shawnnjupt/MIC-Xcorr/README.md

# mic_xcorr

#### 介绍
使用gw2a(tang 20k)进行声源定位的工程，配合sipeed的6+1麦克风

演示视频在这里
https://www.bilibili.com/video/BV1pd4y147E5/?vd_source=da71ba5d951341a80076c3fa4981655b
屏幕截图
