shawnnjupt/MIC-Xcorr/impl/gwsynthesis/top_syn_resource.html

# Hierarchy Module Resource

MODULE NAME | REG NUMBER | ALU NUMBER | LUT NUMBER | DSP NUMBER | BSRAM NUMBER | SSRAM NUMBER
top (F:/code/fpga/MIC_HDMI_FINISHED/src/top.v) | 1818 | 208 | 2395 | - | 16 | 117
|--cmos_pll_m0 (F:/code/fpga/MIC_HDMI_FINISHED/src/top.v) | - | - | - | - | - | -
|--mem_pll_m0 (F:/code/fpga/MIC_HDMI_FINISHED/src/top.v) | - | - | - | - | - | -
|--i2c_config_m0 (F:/code/fpga/MIC_HDMI_FINISHED/src/top.v) | 13 | - | 38 | - | - | -
|--i2c_master_top_m0 (F:/code/fpga/MIC_HDMI_FINISHED/src/i2c_master/i2c_config.v) | 17 | - | 690 | - | - | -
|--byte_controller (F:/code/fpga/MIC_HDMI_FINISHED/src/i2c_master/i2c_master_top.v) | 23 | - | 50 | - | - | -
|--bit_controller (F:/code/fpga/MIC_HDMI_FINISHED/src/i2c_master/i2c_master_byte_ctrl.v) | 71 | 15 | 90 | - | - | -
|--cmos_8_16bit_m0 (F:/code/fpga/MIC_HDMI_FINISHED/src/top.v) | 29 | - | 3 | - | - | -
|--syn_gen_inst (F:/code/fpga/MIC_HDMI_FINISHED/src/top.v) | 48 | 8 | 60 | - | - | -
|--u_tmds_rpll (F:/code/fpga/MIC_HDMI_FINISHED/src/top.v) | - | - | - | - | - | -
|--vitual_image_inst (F:/code/fpga/MIC_HDMI_FINISHED/src/top.v) | 56 | 196 | 1224 | 21 | - | -
|--mic_serial_inst (F:/code/fpga/MIC_HDMI_FINISHED/src/top.v) | 200 | 20 | 180 | - | - | 18
|--mic_sample_inst1 (F:/code/fpga/MIC_HDMI_FINISHED/src/mic_serial.v) | 101 | 7 | 7 | - | - | -
|--mic_sample_inst2 (F:/code/fpga/MIC_HDMI_FINISHED/src/mic_serial.v) | 50 | 7 | 3 | - | - | -
|--mic_sample_inst3 (F:/code/fpga/MIC_HDMI_FINISHED/src/mic_serial.v) | 104 | 7 | 5 | - | - | -
|--xcorr1 (F:/code/fpga/MIC_HDMI_FINISHED/src/top.v) | 113 | 35 | 143 | 1 | - | -
|--mic_data_store_inst1 (F:/code/fpga/MIC_HDMI_FINISHED/src/xcorr.v) | 12 | - | 18 | - | - | -
|--Gowin_SDPB_inst2 (F:/code/fpga/MIC_HDMI_FINISHED/src/mic_data_store.v) | - | - | - | - | 1 | -
|--mic_data_store_inst2 (F:/code/fpga/MIC_HDMI_FINISHED/src/xcorr.v) | 11 | - | 17 | - | - | -
|--Gowin_SDPB_inst2 (F:/code/fpga/MIC_HDMI_FINISHED/src/mic_data_store.v) | - | - | - | - | 1 | -
|--xcorr2 (F:/code/fpga/MIC_HDMI_FINISHED/src/top.v) | 110 | 35 | 137 | 1 | - | -
|--mic_data_store_inst1 (F:/code/fpga/MIC_HDMI_FINISHED/src/xcorr.v) | 11 | - | 17 | - | - | -
|--Gowin_SDPB_inst2 (F:/code/fpga/MIC_HDMI_FINISHED/src/mic_data_store.v) | - | - | - | - | 1 | -
|--mic_data_store_inst2 (F:/code/fpga/MIC_HDMI_FINISHED/src/xcorr.v) | 11 | - | 17 | - | - | -
|--Gowin_SDPB_inst2 (F:/code/fpga/MIC_HDMI_FINISHED/src/mic_data_store.v) | - | - | - | - | 1 | -
|--xcorr3 (F:/code/fpga/MIC_HDMI_FINISHED/src/top.v) | 110 | 35 | 145 | 1 | - | -
|--mic_data_store_inst1 (F:/code/fpga/MIC_HDMI_FINISHED/src/xcorr.v) | 11 | - | 17 | - | - | -
|--Gowin_SDPB_inst2 (F:/code/fpga/MIC_HDMI_FINISHED/src/mic_data_store.v) | - | - | - | - | 1 | -
|--mic_data_store_inst2 (F:/code/fpga/MIC_HDMI_FINISHED/src/xcorr.v) | 11 | - | 17 | - | - | -
|--Gowin_SDPB_inst2 (F:/code/fpga/MIC_HDMI_FINISHED/src/mic_data_store.v) | - | - | - | - | 1 | -
|--xcorr4 (F:/code/fpga/MIC_HDMI_FINISHED/src/top.v) | 110 | 35 | 142 | 1 | - | -
|--mic_data_store_inst1 (F:/code/fpga/MIC_HDMI_FINISHED/src/xcorr.v) | 11 | - | 17 | - | - | -
|--Gowin_SDPB_inst2 (F:/code/fpga/MIC_HDMI_FINISHED/src/mic_data_store.v) | - | - | - | - | 1 | -
|--mic_data_store_inst2 (F:/code/fpga/MIC_HDMI_FINISHED/src/xcorr.v) | 11 | - | 17 | - | - | -
|--Gowin_SDPB_inst2 (F:/code/fpga/MIC_HDMI_FINISHED/src/mic_data_store.v) | - | - | - | - | 1 | -
|--steer_inst1 (F:/code/fpga/MIC_HDMI_FINISHED/src/top.v) | 41 | 18 | 101 | - | - | -
|--steer_inst2 (F:/code/fpga/MIC_HDMI_FINISHED/src/top.v) | 37 | 18 | 108 | - | - | -
|--Btn_Control_inst1 (F:/code/fpga/MIC_HDMI_FINISHED/src/top.v) | 2 | - | 1 | - | - | -
|--Btn_Sample_Clk_inst (F:/code/fpga/MIC_HDMI_FINISHED/src/btn_control.v) | 20 | 19 | 7 | - | - | -
|--ahb_communicate_inst (F:/code/fpga/MIC_HDMI_FINISHED/src/top.v) | 49 | - | 50 | - | - | -
|--Gowin_PicoRV32_Top_inst (F:/code/fpga/MIC_HDMI_FINISHED/src/top.v) | 3481 | 528 | 4974 | 1 | 8 | 8
|--max_sample_inst (F:/code/fpga/MIC_HDMI_FINISHED/src/top.v) | 33 | - | 50 | - | - | -
