shawnnjupt/MIC-Xcorr/src/gowin_sdpb/gowin_sdpb_tmp.v

//Copyright (C)2014-2022 Gowin Semiconductor Corporation.
//All rights reserved.
//File Title: Template file for instantiation
//GOWIN Version: V1.9.8.07
//Part Number: GW2A-LV18PG256C8/I7
//Device: GW2A-18C
//Created Time: Wed Nov 09 22:04:41 2022

//Change the instance name and port connections to the signal names
//--------Copy here to design--------

    Gowin_SDPB your_instance_name(
        .dout(dout_o), //output [17:0] dout
        .clka(clka_i), //input clka
        .cea(cea_i), //input cea
        .reseta(reseta_i), //input reseta
        .clkb(clkb_i), //input clkb
        .ceb(ceb_i), //input ceb
        .resetb(resetb_i), //input resetb
        .oce(oce_i), //input oce
        .ada(ada_i), //input [9:0] ada
        .din(din_i), //input [17:0] din
        .adb(adb_i) //input [9:0] adb
    );

//--------Copy end-------------------
